tristan-yk/dead-reckoning/Electrical/dead_reckoning_shield/custom components/models/1825910-6.step

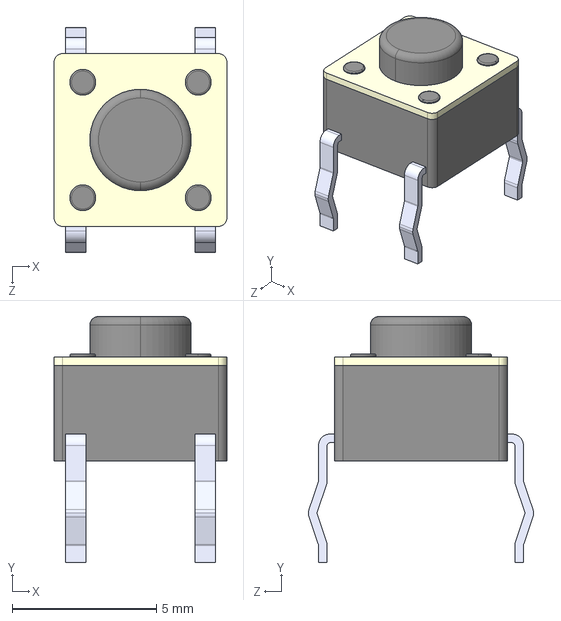
[picture p3: CAD file, 2025-12-14]
Electrical/dead_reckoning_shield/custom components/models/1825910-6.step
5.99 x 8.52 x 7.80 mm
