tristan-yk/dead-reckoning/Electrical/dead_reckoning_shield/dead_reckoning_shield.kicad_pcb

## KiCad design Electrical/dead_reckoning_shield/dead_reckoning_shield.kicad_pcb (2025-12-14)

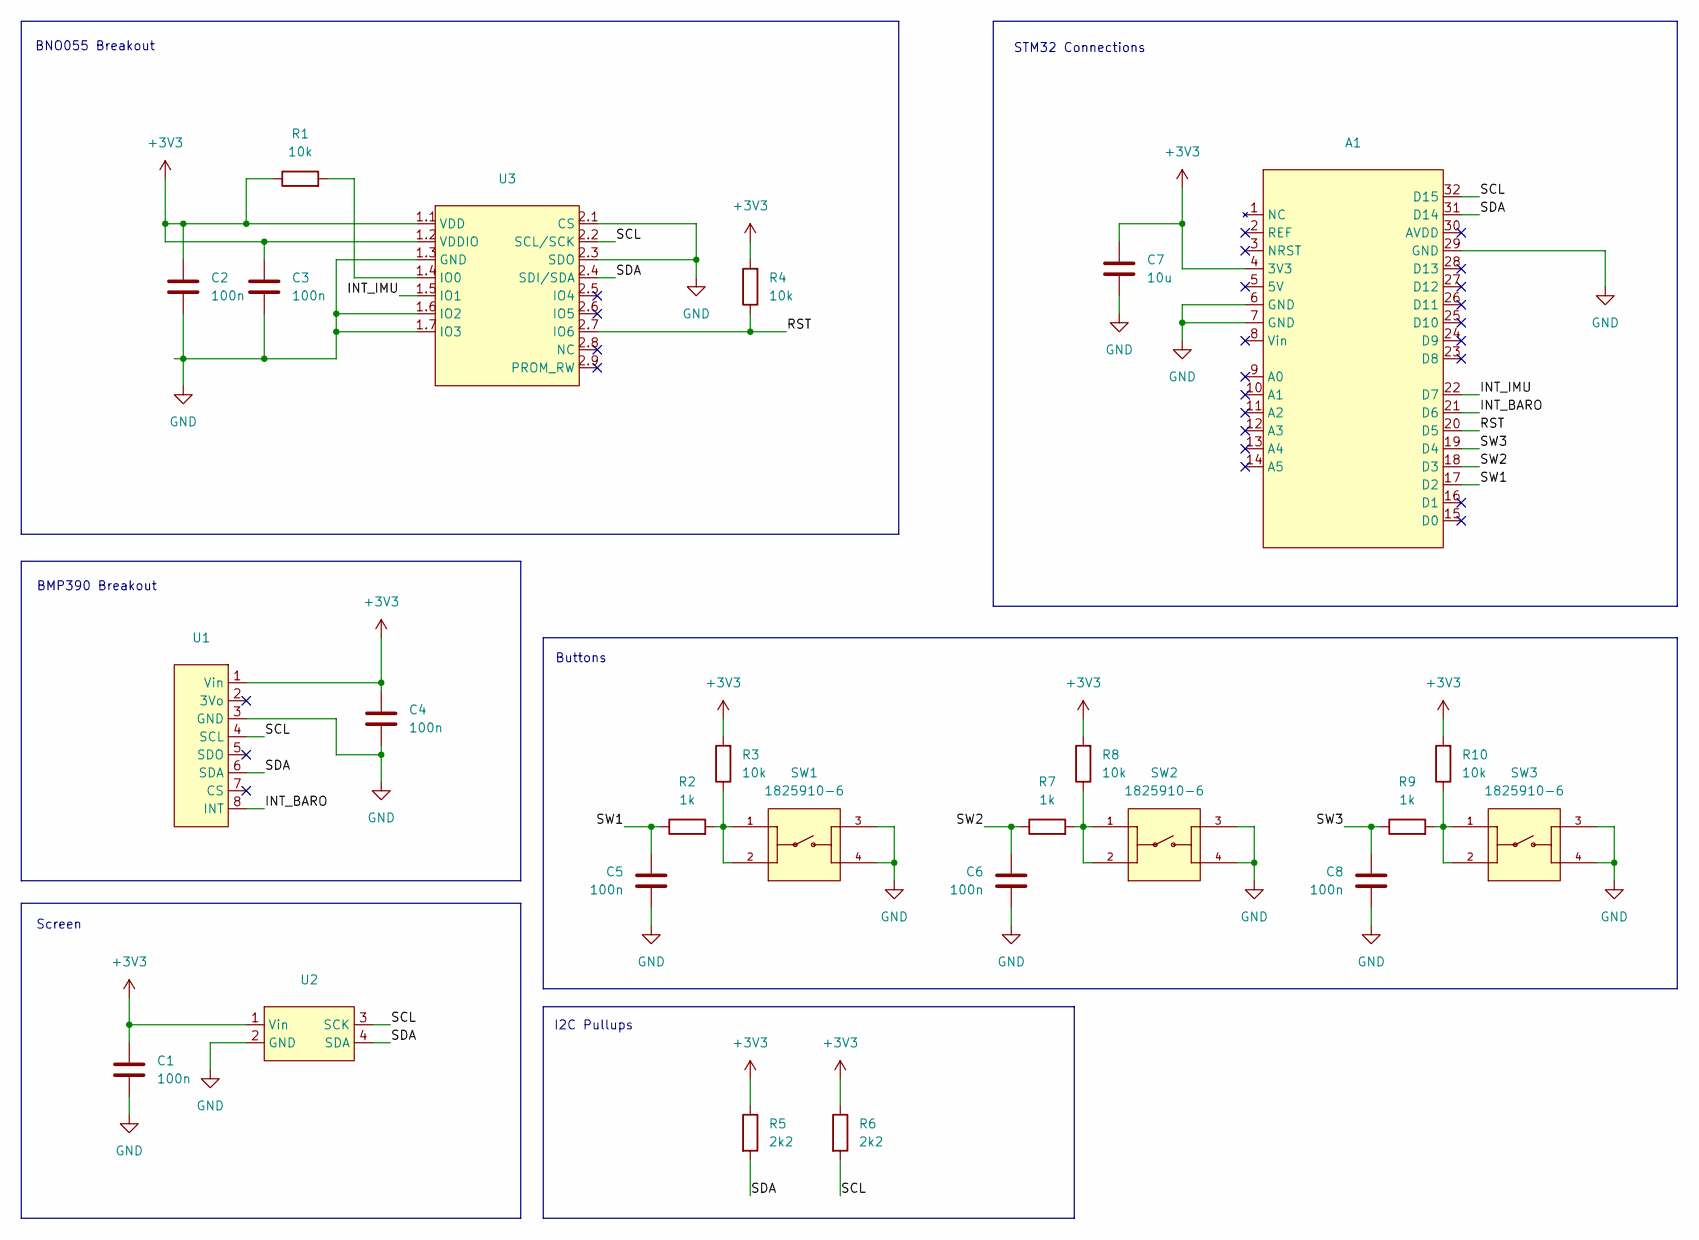
[picture p4: schematic dead_reckoning_shield.kicad_sch]

Parts:
A1: STM32_Shield
C1, C2, C3, C4, C5, C6, C8: 100n; C_0603_1608Metric_Pad1.08x0.95mm_HandSolder
C7: 10u; C_0805_2012Metric_Pad1.18x1.45mm_HandSolder
R1, R3, R4, R8, R10: 10k; R_0603_1608Metric_Pad0.98x0.95mm_HandSolder
R2, R7, R9: 1k; R_0603_1608Metric_Pad0.98x0.95mm_HandSolder
R5, R6: 2k2; R_0603_1608Metric_Pad0.98x0.95mm_HandSolder
SW1, SW2, SW3: 1825910-6; SW_1825910-6-4; PARTREV C10
U1: BMP390
U2: Screen
U3: BNO055

Connections:
+3V3: A1.4 (3V3), C1.1, C2.1, C3.1, C4.1, C7.1, R1.1, R3.2, R4.2, R5.1, R6.1, R8.2, R10.2, U1.1 (Vin), U2.1 (Vin), U3.1.1 (VDD), U3.1.2 (VDDIO)
/INT_BARO: A1.21 (D6), U1.8 (INT)
/INT_IMU: A1.22 (D7), U3.1.5 (IO1)
/RST: A1.20 (D5), R4.1, U3.2.7 (IO6)
/SCL: A1.32 (D15), R6.2, U1.4 (SCL), U2.3 (SCK), U3.2.2 (SCL/SCK)
/SDA: A1.31 (D14), R5.2, U1.6 (SDA), U2.4 (SDA), U3.2.4 (SDI/SDA)
/SW1: A1.17 (D2), C5.1, R2.1
/SW2: A1.18 (D3), C6.1, R7.1
/SW3: A1.19 (D4), C8.1, R9.1
GND: A1.6 (GND), A1.7 (GND), A1.29 (GND), C1.2, C2.2, C3.2, C4.2, C5.2, C6.2, C7.2, C8.2, SW1.3, SW1.4, SW2.3, SW2.4, SW3.3, SW3.4, U1.3 (GND), U2.2 (GND), U3.1.3 (GND), U3.1.6 (IO2), U3.1.7 (IO3), U3.2.1 (CS), U3.2.3 (SDO)
unnamed: R2.2, R3.1, SW1.1, SW1.2
unnamed: R7.2, R8.1, SW2.1, SW2.2
unnamed: R9.2, R10.1, SW3.1, SW3.2
unnamed: R1.2, U3.1.4 (IO0)

Notes on the sheet:
Screen
STM32 Connections
I2C Pullups
BMP390 Breakout
Buttons
BNO055 Breakout

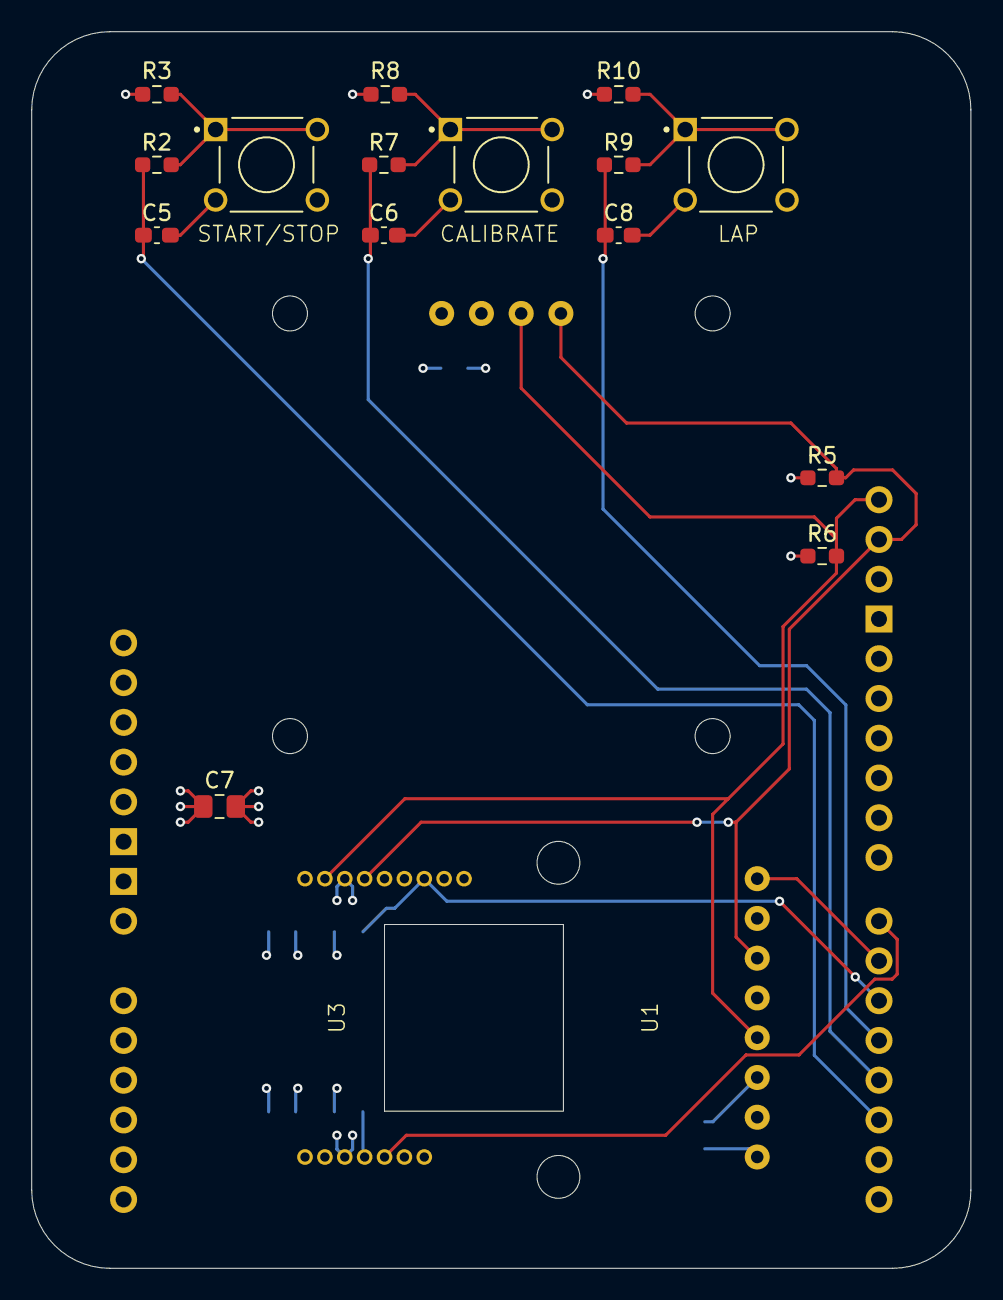
[picture p5: board dead_reckoning_shield.kicad_pcb from above]

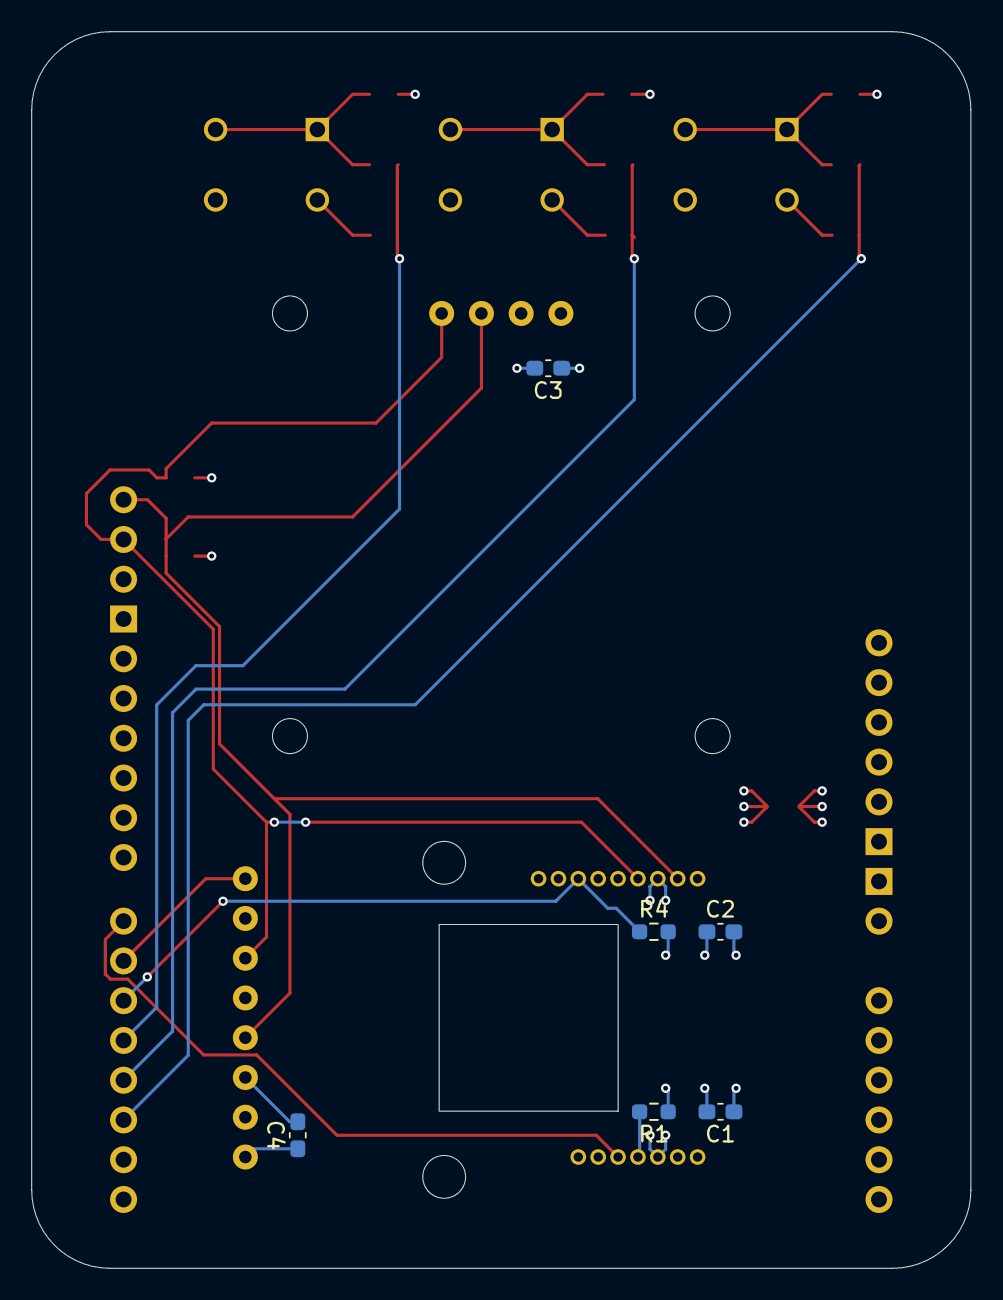
[picture p6: board dead_reckoning_shield.kicad_pcb from below]

Board: 4 copper layers, 60.0 x 79.0 mm, 25 parts (6 on the bottom side), 14 nets.
