tristan-yk/dead-reckoning/Firmware/dead_reckoning.ioc

Mcu.UserName=STM32G431RBTx
PA10.GPIO_Label=BTN_START_STOP
PA10.Signal=GPIO_Input
PA13.Signal=SYS_JTMS-SWDIO
PA14.Signal=SYS_JTCK-SWCLK
PA2.Signal=USART2_TX
PA3.Signal=USART2_RX
PB3.GPIO_Label=BTN_CAL
PB3.Signal=GPIO_Input
PB5.GPIO_Label=BTN_LAP
PB5.Signal=GPIO_Input
PB8-BOOT0.Signal=I2C1_SCL
PB9.Signal=I2C1_SDA
