tristan-yk/dead-reckoning/(commit log)

2025-12-14 Finished Electrical Design
    [1825910-6.step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]
2025-12-14 sensor initialization and test
2026-09-02 pad filter and dynamics
2026-09-03 filter math done
2026-09-05 Filter works in sim!
2026-09-05 first semi working filter commit!
2026-09-05 accept noisier accel and fix declination behavior
    [filter_entry.c, filter_entry_types.h, main.c, sensors.c, sensors.h]
